rabbitholecomputing/Zulu-Control-Board-i2c/README.md

# Zulu control board hardware
## zulu-ctrl-board-v1.0-kicad
OLED with rotatory with a push button and two more buttons
with an I2C and an added interrupt line.

This design is derived from "ctrl_board_v1p6" in this project:
https://github.com/PiSCSI/piscsi-hw
