rabbitholecomputing/Zulu-Control-Board-i2c/zulu-ctrl-board-v1.0-kicad/ctrl_board.step

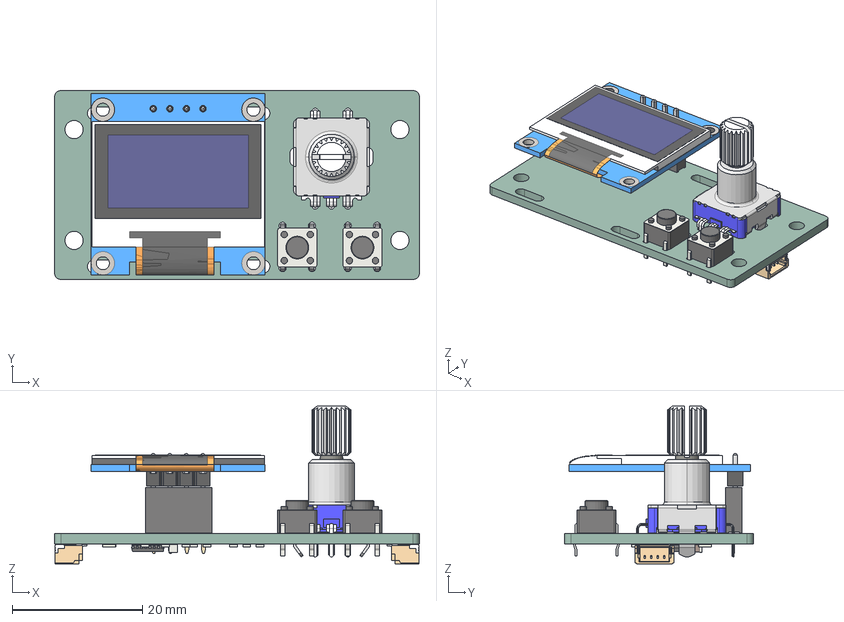
[picture p1: CAD file, 2024-08-06]
zulu-ctrl-board-v1.0-kicad/ctrl_board.step
56.0 x 29.0 x 24.2 mm
ѽת±ძǷEC11E-05SW
SW_PUSH_6mm_h5mm x 2
PinSocket_1x04_P254mm_Vertical
User Library-128x64I2COLEDDisplayAdafruit
R_0805_2012Metric x 10
TSSOP_16_44x5mm_P065mm
C_0805_2012Metric
SM04B-SRSS-TB(LFSN) x 2
ctrl_board_PCB
