rabbitholecomputing/Zulu-Control-Board-i2c/zulu-ctrl-board-v1.0-kicad/ctrl_board-dimensions.pdf

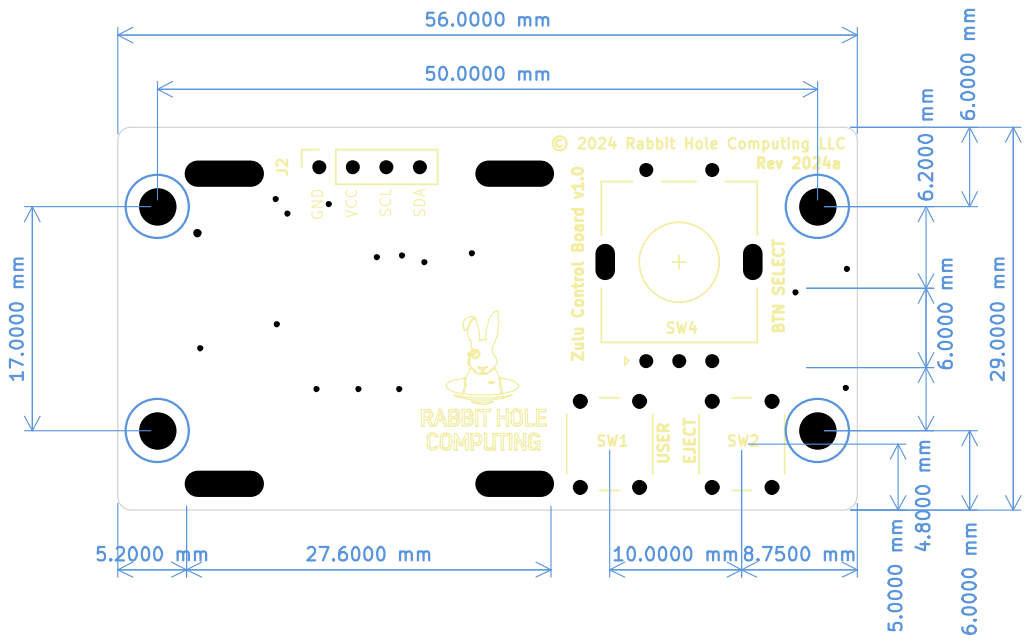
[picture p2: page 1]
