rabbitholecomputing/Zulu-Control-Board-i2c/zulu-ctrl-board-v1.0-kicad/ctrl_board.kicad_pcb

## KiCad design zulu-ctrl-board-v1.0-kicad/ctrl_board.kicad_pcb (2024-08-06)

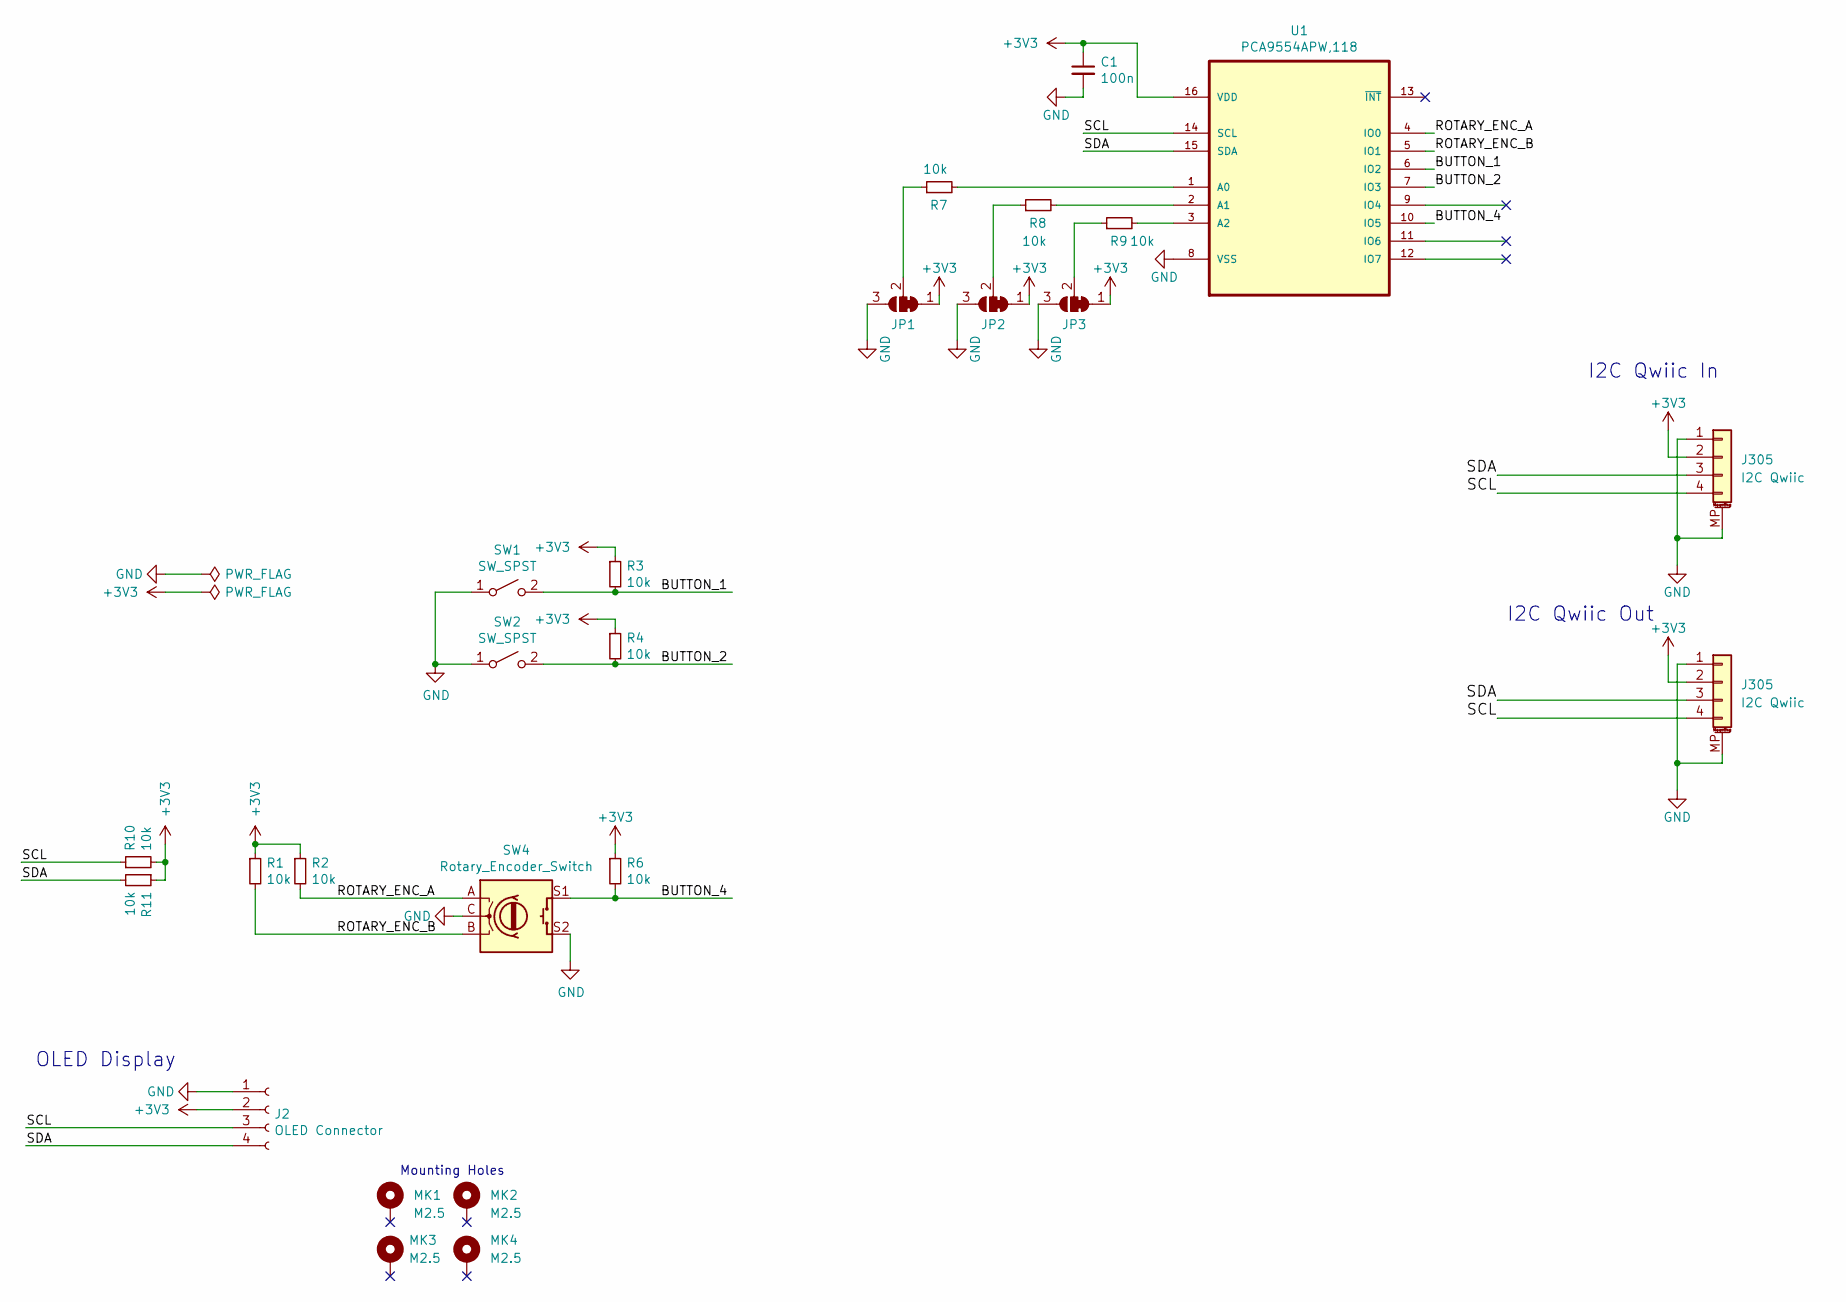
[picture p3: schematic ctrl_board.kicad_sch, Zulu Control Board v1.0]

Parts:
C1: 100n; C_0805_2012Metric; LCSC C49678
J2: OLED Connector; 0.9_and_1.3_in_OLED_Footprint
J305: I2C Qwiic; JST_SH_SM04B-SRSS-TB_1x04-1MP_P1.00mm_Horizontal; LCSC N/A
JP1, JP2, JP3: SolderJumper_3_Bridged12; SolderJumper-3_P1.3mm_Bridged12_RoundedPad1.0x1.5mm
MK1, MK2, MK3, MK4: M2.5; MountingHole_2.8mm_M2.5custom_DIN965_Pad
R1, R2, R3, R4, R6, R7, R8, R9, R10, R11: 10k; R_0805_2012Metric; LCSC C17414
SW1, SW2: SW_SPST; SW_PUSH_6mm_H5mm; LCSC C110153
SW4: Rotary_Encoder_Switch; RotaryEncoder_Alps_EC11E-Switch_Vertical_H20mm
U1: PCA9554APW,118; TSSOP-16_4.4x5mm_P0.65mm; MPN PCA9554APW,118; LCSC C86803

Connections:
+3V3: C1.1, J2.2, JP1.1 (A), JP2.1 (A), JP3.1 (A), R1.1, R2.1, R3.1, R4.1, R6.1, R10.2, R11.1, U1.16 (VDD); also elsewhere on the board
/BUTTON_1: R3.2, SW1.2 (B), U1.6 (IO2)
/BUTTON_2: R4.2, SW2.2 (B), U1.7 (IO3)
/BUTTON_4: R6.2, SW4.S1, U1.10 (IO5)
/ROTARY_ENC_A: R2.2, SW4.A, U1.4 (IO0)
/ROTARY_ENC_B: R1.2, SW4.B, U1.5 (IO1)
/SCL: J2.3, R10.1, U1.14 (SCL); also elsewhere on the board
/SDA: J2.4, R11.2, U1.15 (SDA); also elsewhere on the board
GND: C1.2, J2.1, JP1.3 (B), JP2.3 (B), JP3.3 (B), SW1.1 (A), SW2.1 (A), SW4.C, SW4.S2, U1.8 (VSS); also elsewhere on the board
unnamed: JP1.2 (C), R7.1
unnamed: JP2.2 (C), R8.1
unnamed: JP3.2 (C), R9.1
unnamed: R7.2, U1.1 (A0)
unnamed: R8.2, U1.2 (A1)
unnamed: R9.2, U1.3 (A2)

Notes on the sheet:
I2C Qwiic In
I2C Qwiic Out
OLED Display
Mounting Holes

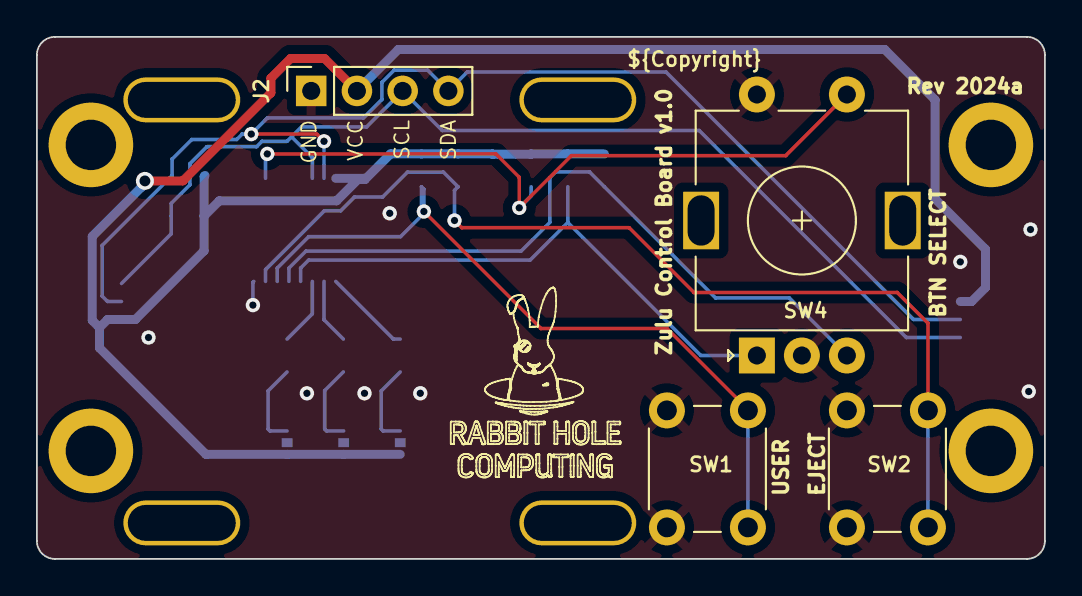
[picture p4: board ctrl_board.kicad_pcb from above]

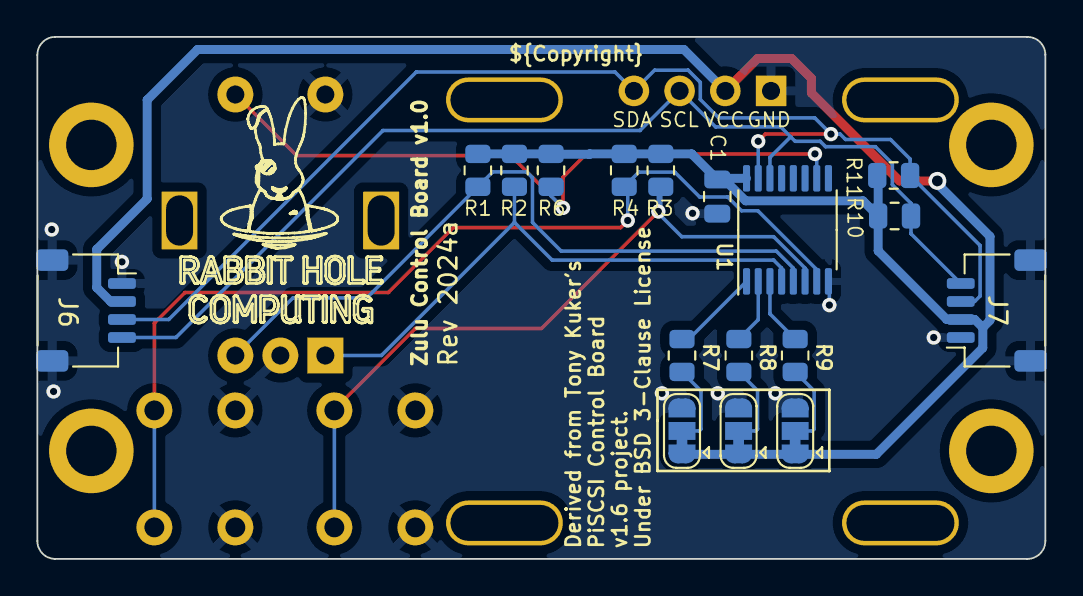
[picture p5: board ctrl_board.kicad_pcb from below]

Board: 2 copper layers, 56.0 x 29.0 mm, 25 parts (19 on the bottom side), 15 nets.

Other parts of the board:
J6, J7: I2C Qwiic; JST_SH_SM04B-SRSS-TB_1x04-1MP_P1.00mm_Horizontal

Their connections:
+3V3: J6.2, J7.2; also elsewhere on the board
/SCL: J6.4, J7.4; also elsewhere on the board
/SDA: J6.3, J7.3; also elsewhere on the board
GND: J6.1, J6.MP (MountPin), J7.1, J7.MP (MountPin); also elsewhere on the board
