rabbitholecomputing/Zulu-Control-Board-i2c/(threads)

Thread 1 (2025-05-02):

Rotary Encoder Problem

lomdar67, 2025-05-02:
I build the control board, but I have a problem with the rotary encode. It takes three impulses (clicks) until the "cursor" moves in any direction.
Is this a hardware problem or could the be fixed with a firmware update?
