rabbitholecomputing/Zulu-Control-Board-i2c/(commit log)

2024-08-05 Design of new rev
    Dropped 2.54mm pitch I2C headers, except for display
    Removed LEDs
    Added two more mounting holes. Made all 4 of them 2.8mm holes
    Decreased the size of the board
    Moved buttons, rotary, and screen closer together
    [BOM-piscsi.csv, Connectors.kicad_sch, Connectors.sch, IIciCase.FCStd, PCA9554APW_118.step, Serial_Eeprom.sch, USB_Conn.kicad_sch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]
2024-08-06 Add dimensions and create step file
    Added dimensions and adjusted some part locations to the nearest 0.1mm
    Generated a 3D model step file
    [ctrl_board.kicad_pcb, ctrl_board.kicad_sch, ctrl_board.step]
