rabbitholecomputing/Zulu-Control-Board-i2c/(notices)

Notices in the files:
zulu-ctrl-board-v1.0-kicad/ctrl_board.kicad_pcb:
Under BSD 3-Clause License
parts and their libraries:
Copyright: © 2024 Rabbit Hole Computing LLC
